Pollex/MFM-Module-JSN-SR04T/hardware/exports/jsnsr04t.pdf

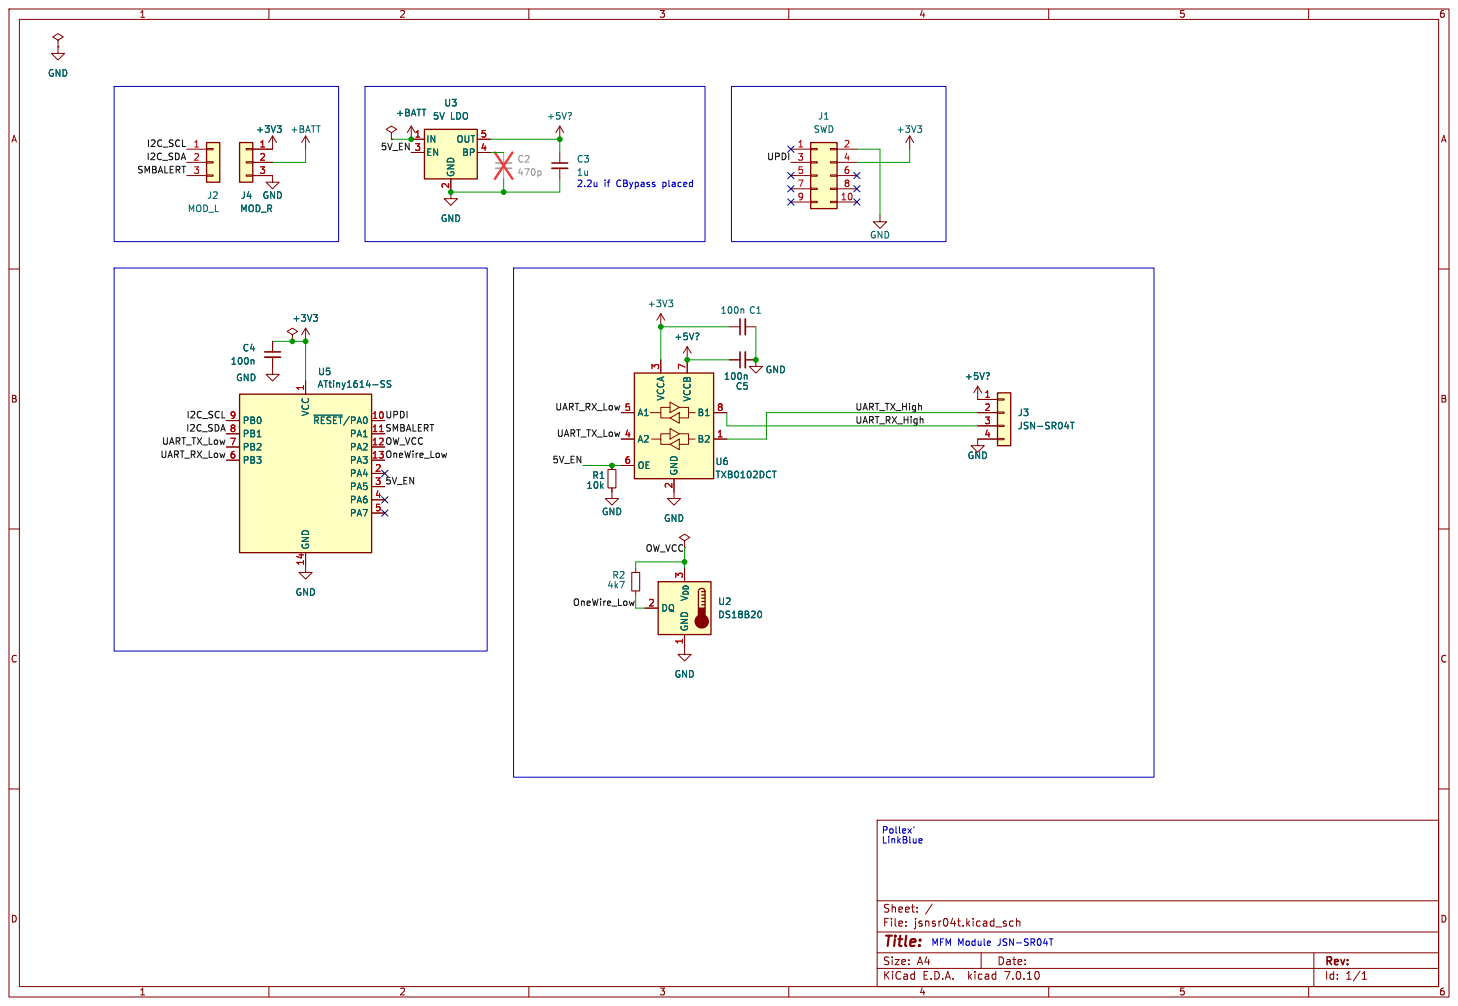
[picture p1: page 1]

1 ~{RESET}/PA010 PA1 11 PA2 12 PA3 13 GND 14 PA4 2 PA5 3 PA6 4 PA7 5 PB3 6 PB2 7 PB1 8 PB0 9 U5 ATtiny1614-SS GND

2 EN 3 BP 4 OUT 5 GND GND

2 EN 3 BP 4 OUT 5 U3 +BATT 5V LDO
2.2u if CBypass placed GND GND

Id: 1/1 Title: File: jsnsr04t.kicad_sch Sheet: /
