Pollex/MFM-Module-JSN-SR04T/hardware/exports/pcb.pdf

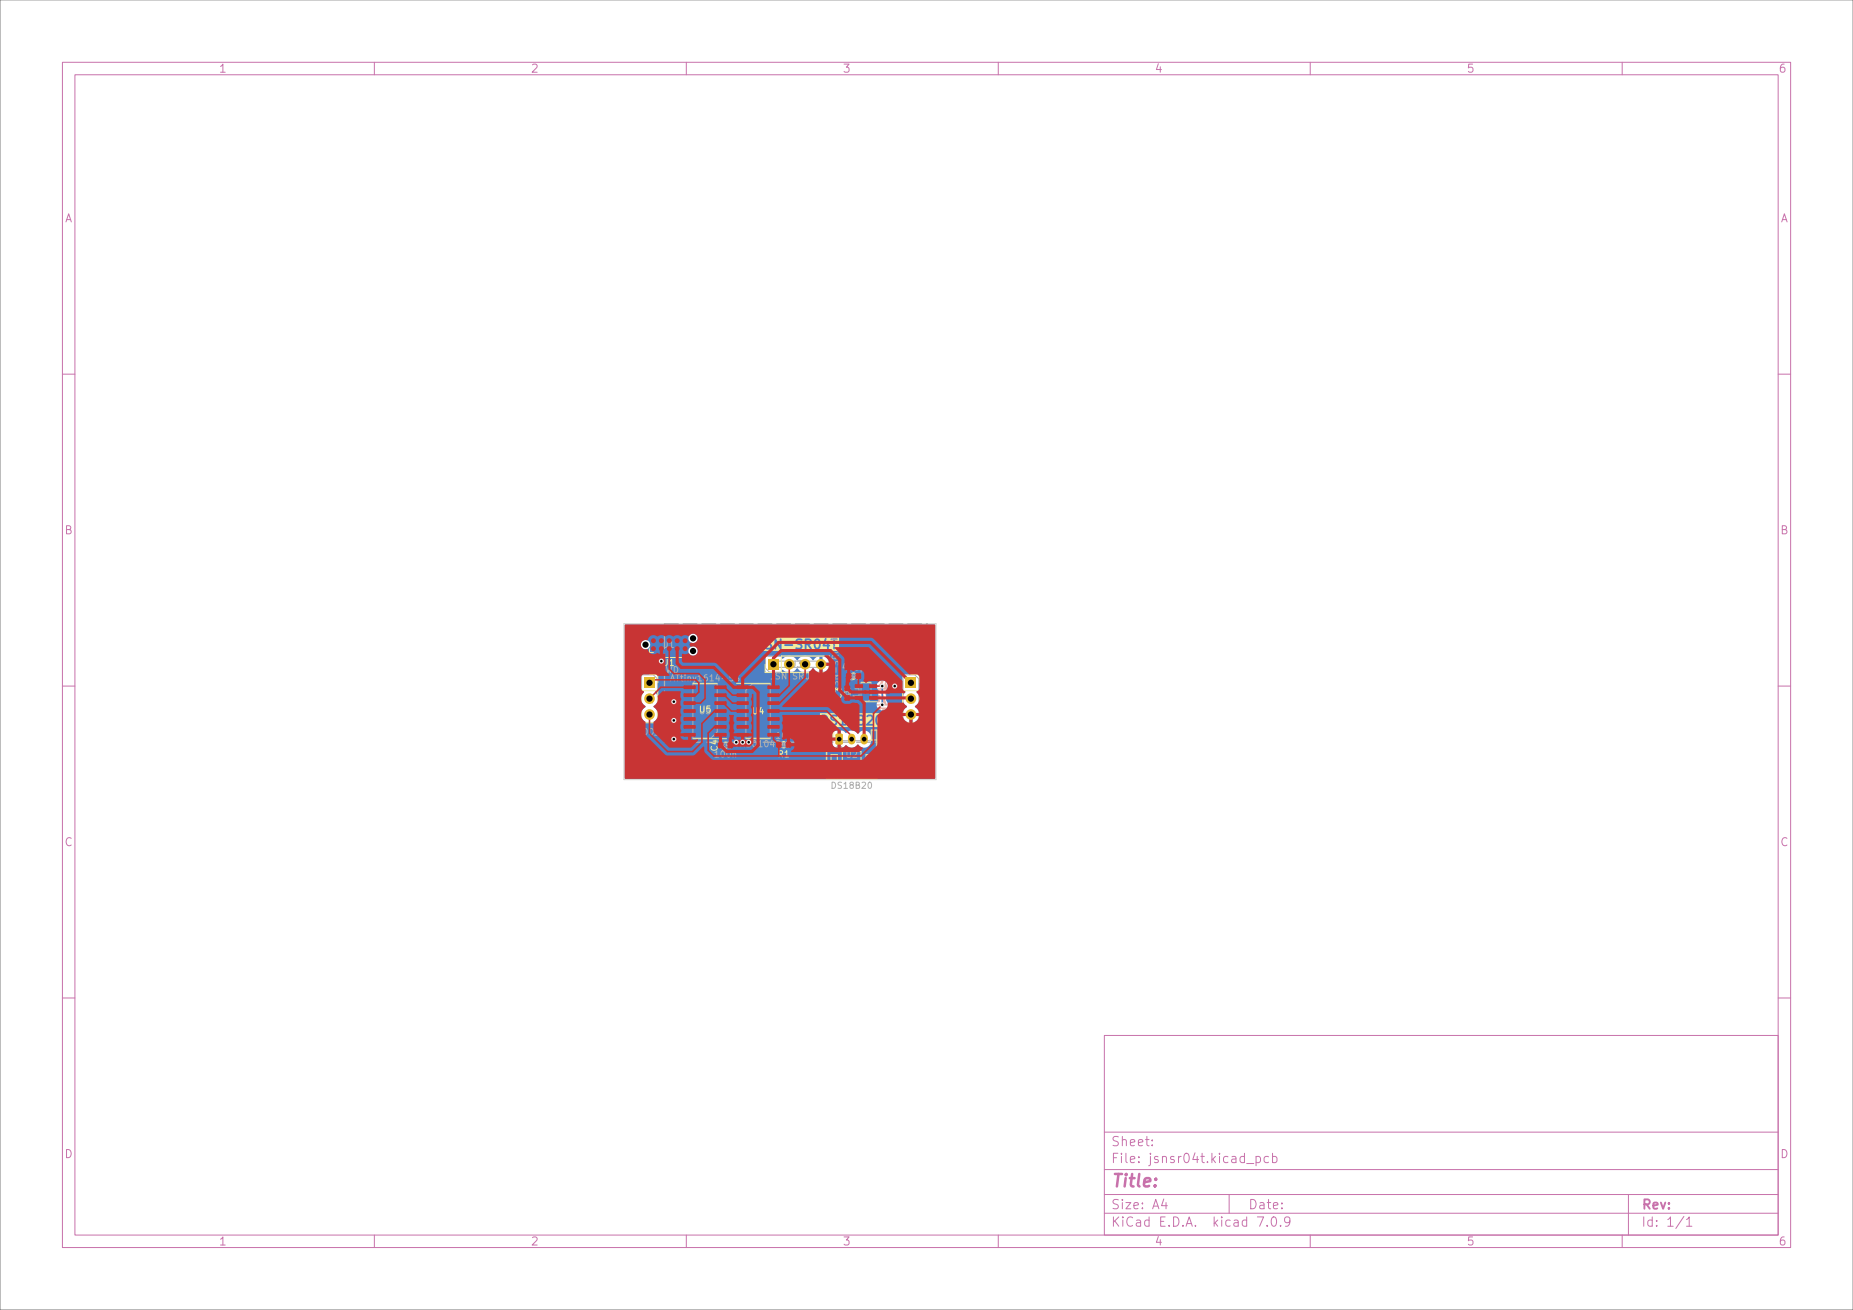
[picture p2: page 1]
