Pollex/MFM-Module-JSN-SR04T/hardware/jsnsr04t.kicad_pcb

## KiCad design hardware/jsnsr04t.kicad_pcb (2024-02-22)

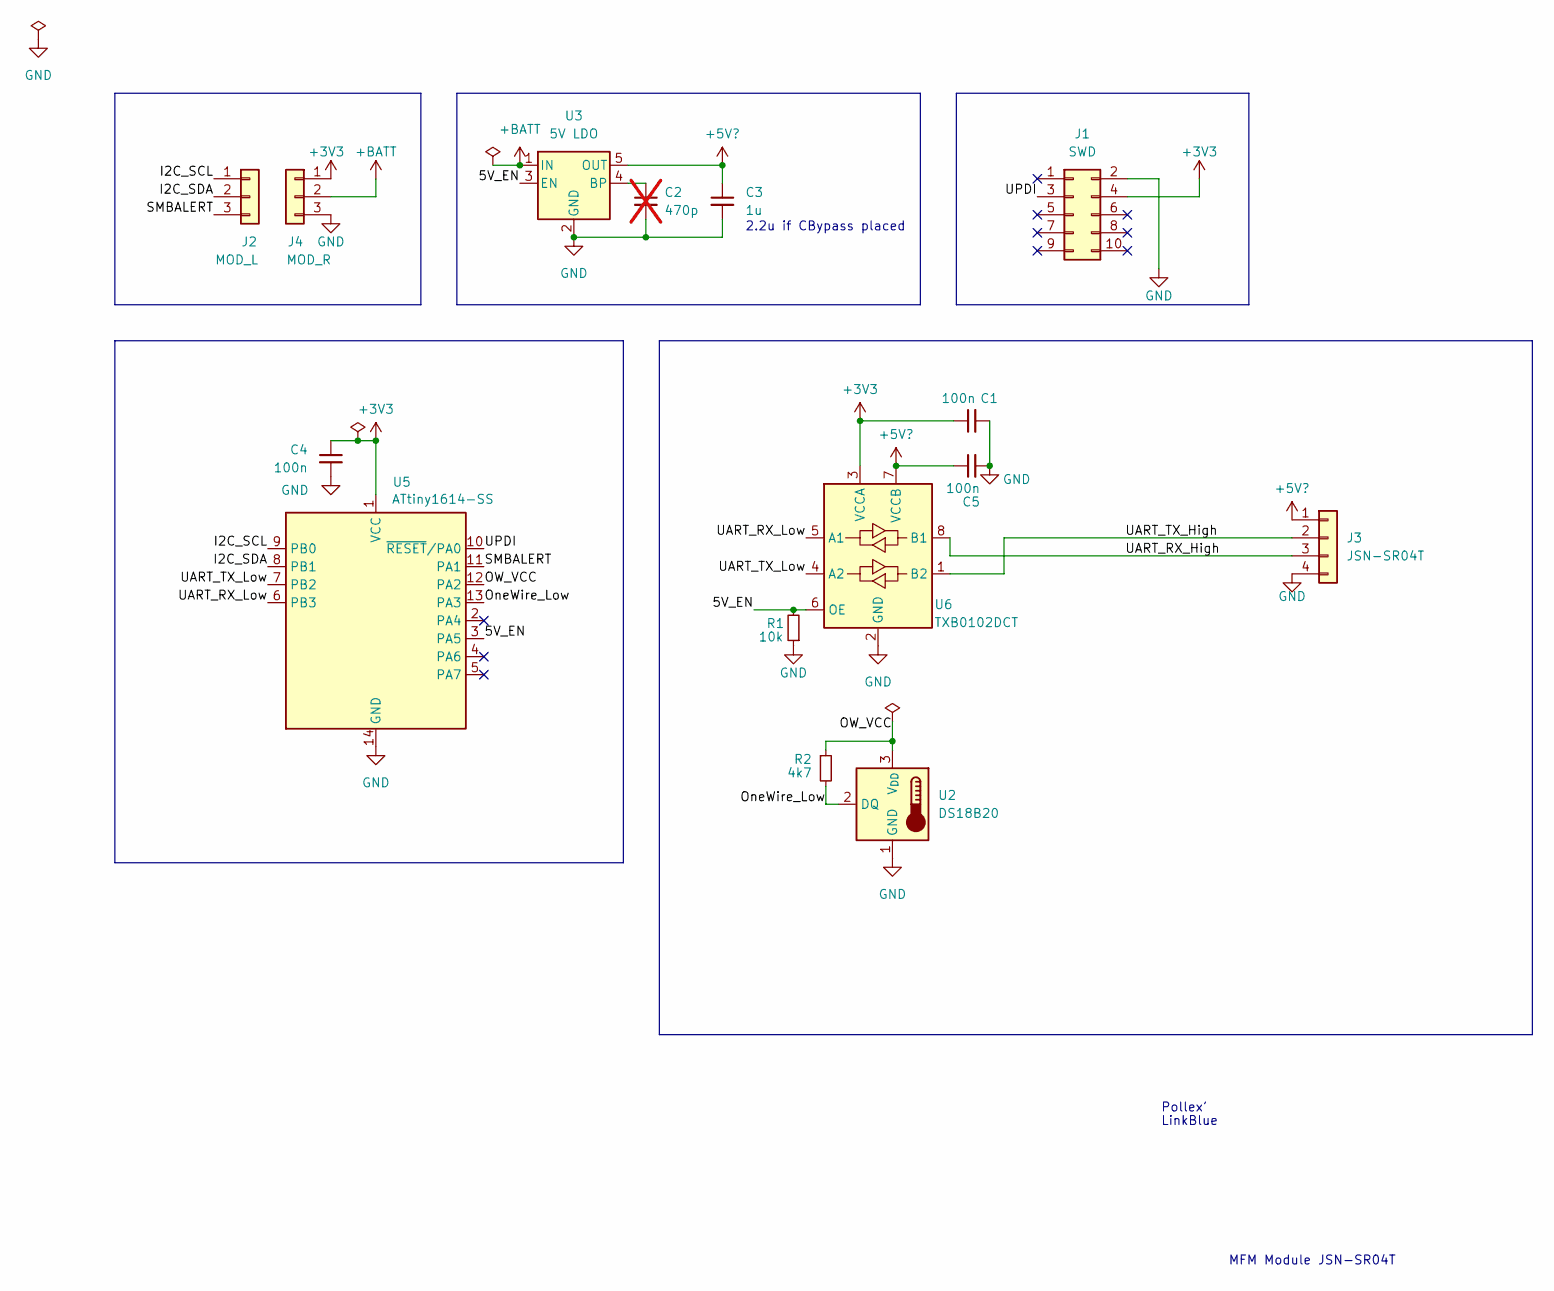
[picture p3: schematic jsnsr04t.kicad_sch]

Parts:
C1, C4, C5: 100n; C_0603_1608Metric
C2: 470p; C_0603_1608Metric; not fitted
C3: 1u; C_0603_1608Metric
J1: SWD; Tag-Connect_TC2050-IDC-NL_2x05_P1.27mm_Vertical
J2: MOD_L; PinSocket_1x03_P2.54mm_Vertical
J3: JSN-SR04T; PinHeader_1x04_P2.54mm_Vertical
J4: MOD_R; PinSocket_1x03_P2.54mm_Vertical
R1: 10k; R_0603_1608Metric
R2: 4k7; R_0603_1608Metric
U2: DS18B20; TE-Connectivity_3_pin_terminal_block
U3: 5V LDO; SOT-23-5
U5: ATtiny1614-SS; SOIC-14_3.9x8.7mm_P1.27mm
U6: TXB0102DCT; TSSOP-8_3x3mm_P0.65mm

Connections:
+3V3: C1.1, C4.1, J1.4, J4.1, U5.1 (VCC), U6.3 (VCCA)
+5V?: C3.1, C5.1, J3.1, U3.5 (OUT), U6.7 (VCCB)
+BATT: J4.2, U3.1 (IN)
/5V_EN: R1.2, U3.3 (EN), U5.3 (PA5), U6.6 (OE)
/I2C_SCL: J2.1, U5.9 (PB0)
/I2C_SDA: J2.2, U5.8 (PB1)
/OW_VCC: R2.1, U2.3 (V_{DD}), U5.12 (PA2)
/OneWire_Low: R2.2, U2.2 (DQ), U5.13 (PA3)
/SMBALERT: J2.3, U5.11 (PA1)
/UART_RX_High: J3.3, U6.8 (B1)
/UART_RX_Low: U5.6 (PB3), U6.5 (A1)
/UART_TX_High: J3.2, U6.1 (B2)
/UART_TX_Low: U5.7 (PB2), U6.4 (A2)
/UPDI: J1.3, U5.10 (~RESET/PA0)
GND: C1.2, C2.2, C3.2, C4.2, C5.2, J1.2, J3.4, J4.3, R1.1, U2.1 (GND), U3.2 (GND), U5.14 (GND), U6.2 (GND)
unnamed: C2.1, U3.4 (BP)

Notes on the sheet:
LinkBlue
2.2u if CBypass placed
MFM Module JSN-SR04T
Pollex'

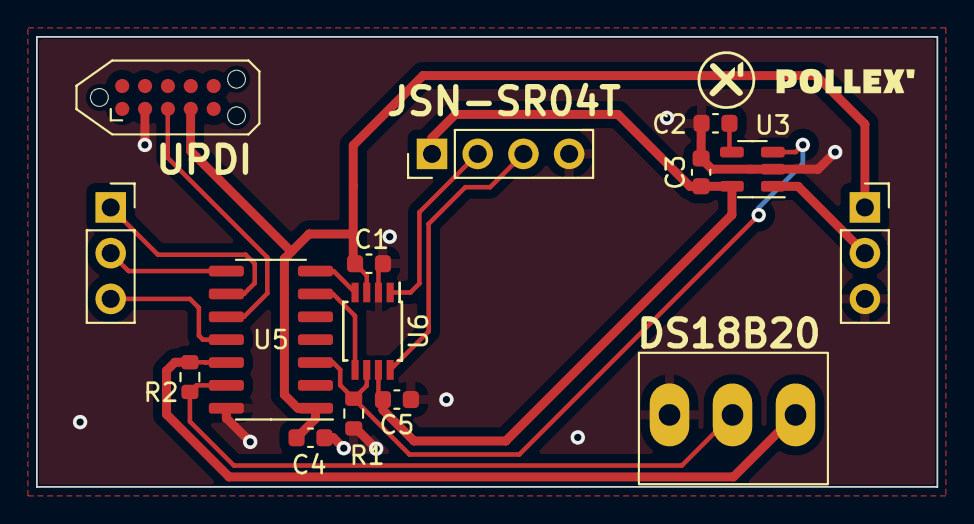
[picture p4: board jsnsr04t.kicad_pcb from above]

Board: 2 copper layers, 50.0 x 25.0 mm, 15 parts (0 on the bottom side), 16 nets.
