Pollex/MFM-Module-JSN-SR04T/include/app_jsnsr04t.h

#ifndef APP_JSNSR04T_H
#define APP_JSNSR04T_H

#include <stdint.h>

#ifdef __cplusplus
extern "C" {
#endif

void jsnsr04t_init(void);
uint16_t jsnsr04t_read(void);

#ifdef __cplusplus
}
#endif

#endif /* end of include guard: APP_JSNSR04T_H */
