Pollex/MFM-Module-JSN-SR04T/include/mcu_uart.h

#if !defined(_UART_H_)
#define _UART_H_

#include <stdint.h>

#define UART_BUFFER_SIZE 1024
#define UART_BAUD_RATE 9600

#ifdef __cplusplus
extern "C" {
#endif

void uart_init(void);
void uart_deinit(void);
uint16_t uart_available(void);
uint16_t uart_read(uint8_t *data, uint16_t len);
void uart_write(uint8_t *data, uint16_t len);
void uart_putc(uint8_t data);
uint8_t uart_getc(void);
uint8_t uart_peek(void);

#ifdef __cplusplus
}
#endif

#endif // _UART_H_
