Pollex/MFM-Module-JSN-SR04T/(commit log)

2023-02-10 Add median filter
2023-12-04 Initial v2 design
    [jsnsr04t.kicad_pcb, jsnsr04t.kicad_sch, levelshifter.kicad_sch]
2023-12-04 Route PCB
    [jsnsr04t.kicad_pcb]
2024-01-09 Include terminal blocks for DS18B20
    [jsnsr04t.kicad_pcb, jsnsr04t.kicad_sch]
2024-02-01 Drive DS18B20 from IO Port\nRemove DS18B20 from level translator
    [jsnsr04t.kicad_pcb, jsnsr04t.kicad_sch]
2024-02-22 Move designator silkscreen
    [jsnsr04t.kicad_pcb]
2024-03-26 Update FW pins to latest board design
2024-03-26 refactor(firmware): coreless build
    [jsnsr04t.kicad_sch]
2024-03-26 fix(firmware): DS18B20 Resolution to 11 bit (0.125)
    [app.c]
2024-07-30 Fix: extra power saving
    [app.c]
2025-02-17 fix(ds18b20): incorrect temperature calculation
    [app_ds18b20.c]
